seo-d-h/------------/README.md

# Atmega128_Elevator_Project
https://www.youtube.com/watch?v=nzGrvzZ4eBY
## 1. H/W Configuration
### 1) System Operation Part


### 2) System Interface Part


## 2. Flow Chart


## 3. H/W Circuit
### 1) System Operation Part


### 2) System Interface Part
