seo-d-h/------------/보고서_2018144014_서동현.pdf

2018144014 | 서 동 현

# 마이크로프로세서Ⅱ 텀프로젝트 보고서

## 프로젝트 명

< 고오급 엘리베이터 >

목 차

I. 제안 이유 및 필요성-----------------------------

II. 개발 방법 개요

1. 최종 개발 목표 ----------------------------- 3
2. 전체 시스템 구성도 / 센서 및 액추에이터 포함한 H/W구성도
3. 동작 시나리오 제시(Flowchart 및 동작 개요 제시)

III. 요소별 개발 내용 및 검증

1. 각 요소별 회로의 설계 / 구현 결과(회로도 및 동작 검증)
2. 각 요소의 동작을 위한 프로그램 설계 / 구현결과(code 및 동 작검증)
3. 전체 동작 시나리오에 따른 구현

IV. 전체 시나리오에 따른 개발 내용 및 검증

1. 동작 시나리오에 따른 동작 검증
V. 텀프로젝트 수행에 대한 결론 및 기대효과
1. 초기 계획 대비 진행 내용 비교
2. 전체적인 구현에 대한 Overview
3. 프로젝트 진행중 어려웠던 내용과 어떻게 해결하였는지

VI. 소요된 부품 List 및 수행된 일정 정리

## 1장. 제안 이유 및 필요성(산업적/학습 등에 대한 필요성)

1) 산업적 필요성
- 범죄와 테러에 대한 사건 사고 방지

22.08.19 오피스텔 엘리베이터를 기다리던 와중 치한이 묻지마 폭행을 한 사건

이 발생하였다. 이를 예방 및 대비하기 위해 아파트 현관을 인증된 사용자만 출

입 할 수 있도록 한다.

관련자료 : [단독]"엘리베이터 기다리는데 뒤에서 돌려차기" 부산 귀갓길 행인 살인미수 | JTBC 뉴스 (https://news.jtbc.co.kr/article/article.aspx?news_id=NB12071542)
- 4차 산업혁명시대에 맞는 스마트 엘리베이터

오늘날 가정 및 산업에서 이용하는 엘리베이터 시스템은 엘리베이터가 처음 도

입되었을 때 사용한 사용자가 버튼을 눌러야 구동하는 방식임. 4차 산업혁명이

도래됨에 따라 보다 스마트하고 사용자에게 편리하게, 기다리는 시간 없이 엘리

베이터를 사용할 수 있어야 함.

관련자료 : 시간표 데이터를 이용한 엘리베이터 알고리즘 설계[한국정보통신학회 종합 학술대회 눈문집]

22.05 | 122~124
2) 학습 필요성
- 통신 시스템 이해 및 적용

마이크로프로세서2 에서 주로 학습한 통신 시스템(UART, SPI, TWI)을 활용하여

작품을 설계 및 구현한다.

- 센서값에 따른 액추에이터 제어

마이크로프로세서1, 2를 융합하여 센서값을 통해 받아들인 정보에 따라 특정 동

작을 수행하도록 작품을 설계 및 제작한다.

## 2장. 개발 방법 개요

1) 최종 개발 목표
- 승인된 사용자만 건물 출입 할 수 있도록 보안 시스템을 1층 출입문에 구현

한다. 승인여부는 RFID리더기 태그를 통해 승인된 사용자면 출입문이 자동으로

열리게 되며 엘리베이터를 자동으로 1층으로 호출 후, 카드 UID값에 따라 목적

층수를 미리 눌러준다.

승인된 사용자가 아니라면 미승인된 카드라는 경고문구를 LCD 디스플레이에

출력한다.

- 출입문은 서보모터를 이용하여 게이트 open / close를 진행한다.
- 온도센서, 조도세서를 통해 외부환경에 따라 실내 온도 및 조명 환경을 제어

한다.

- 엘리베이터는 리니어 엑추에이터를 이용하여 층 수에 맞게 구별한다.
- 부가적인 기능으로 낮과 밤에 따라서 조도의 값이 바뀌기 때문에

저녁이 되면 조도 값에 따라서 자동으로 복도 LED가 켜진다.

- 예외상황을 대비해 스위치로 엘리베이터를 1층으로 부를 수 있다.

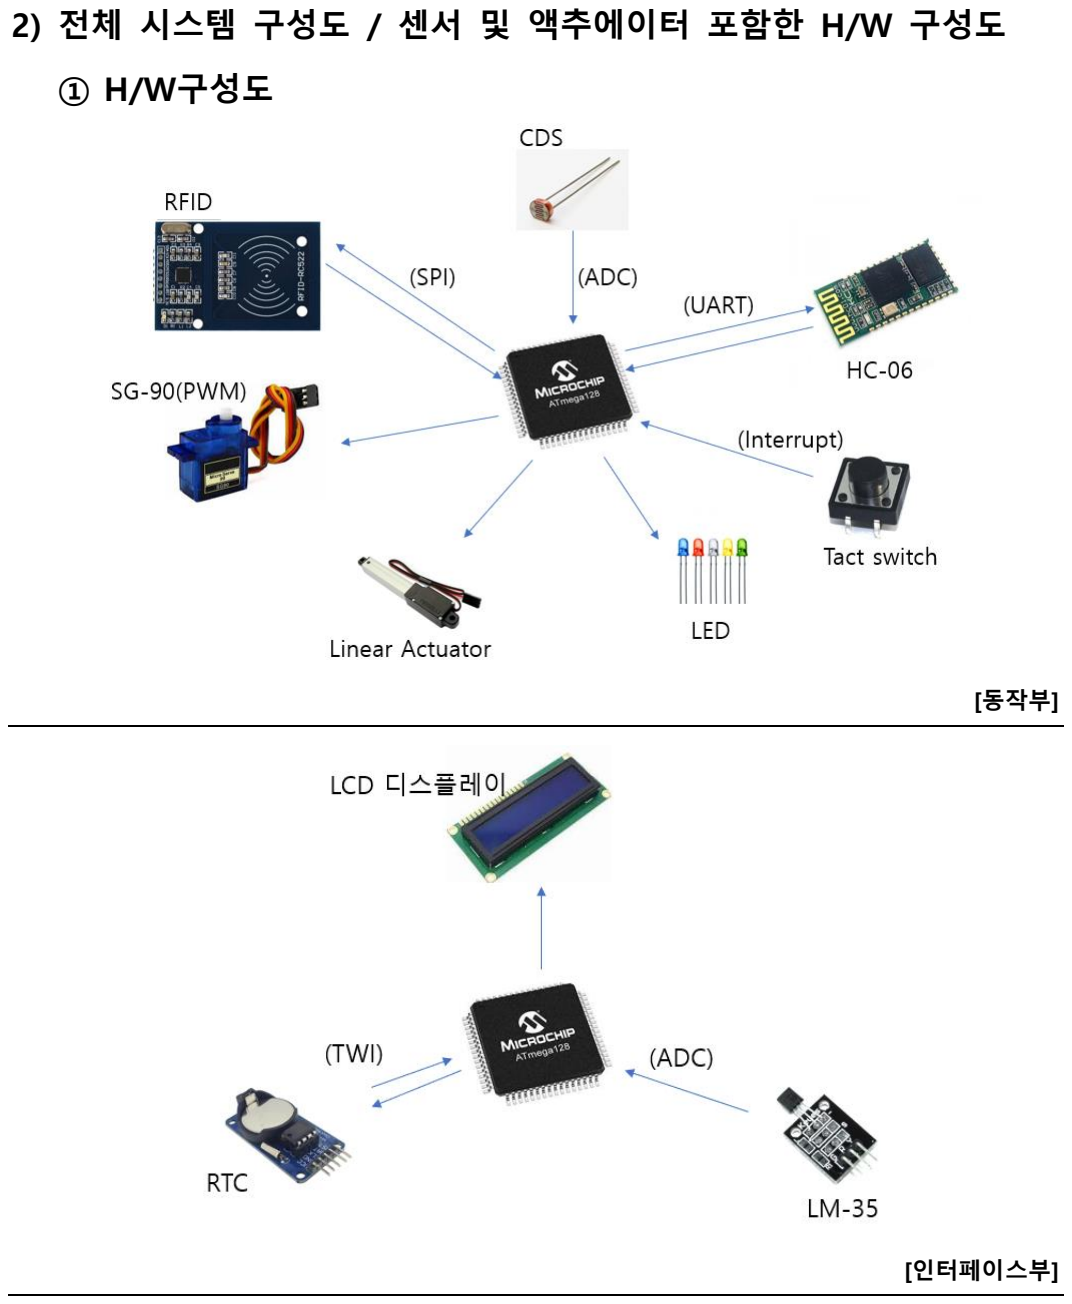
[picture p1: page 5]

2) 전체 시스템 구성도 / 센서 및 액추에이터 포함한 H/W 구성도

① H/W구성도

[동작부]

[인터페이스부]

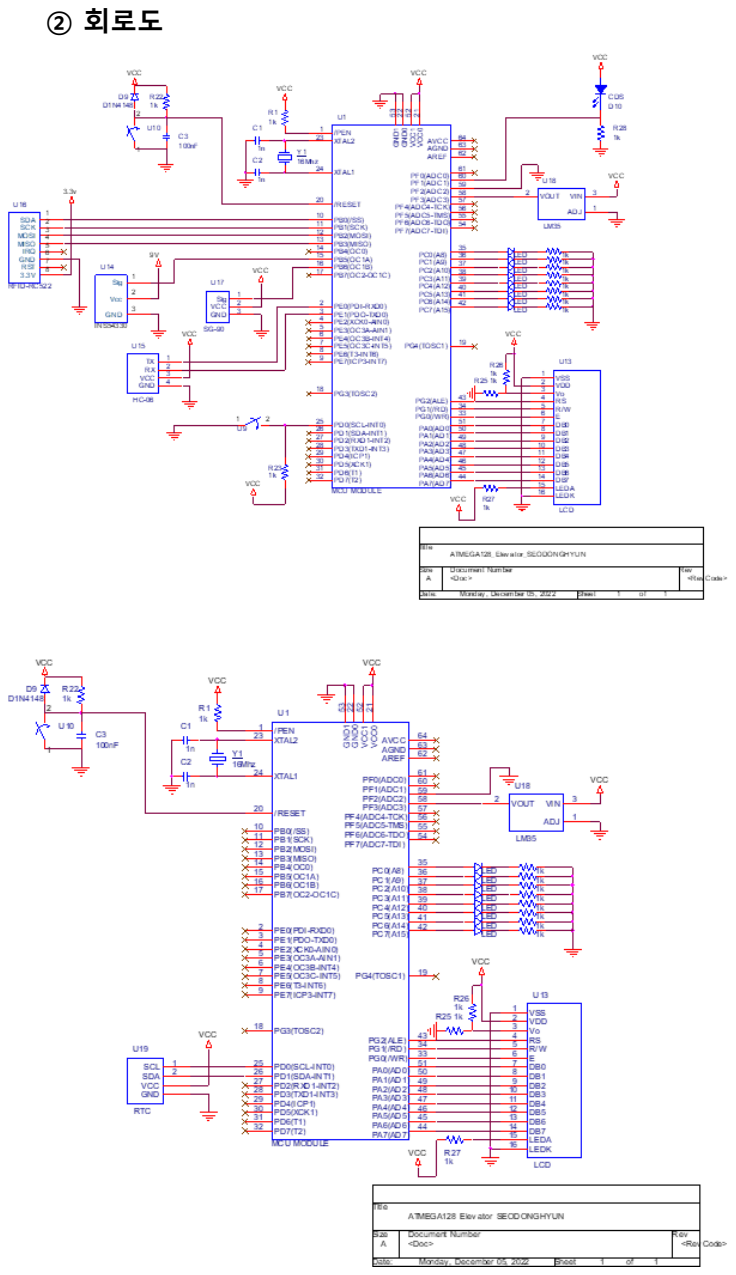
[picture p2: page 6]

② 회로도

3) 동작 시나리오 제시 (Flowchart 및 동작 개요 제시)

① 시스템 구성

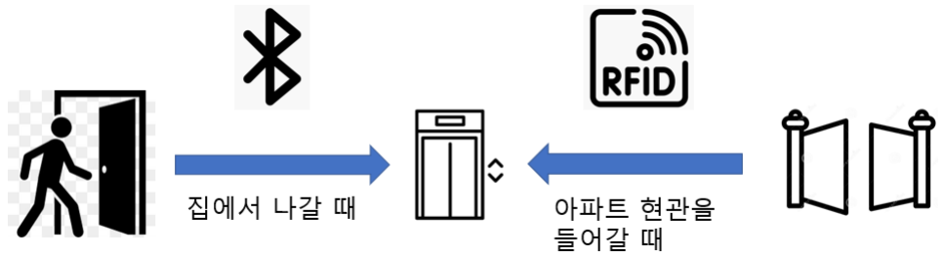
[picture p3: figure]

사용자가 집에서 외출 할 때 휴대폰 블루투스를 통해 엘리베이터를 호출 할

수 있도록 한다. 반대로 실외에서 내부로 출입할 경우는 RFID카드 태그를 통

해 인증된 사용자만 출입을 허용할 수 있도록 게이트를 Open한다.

② 흐름도

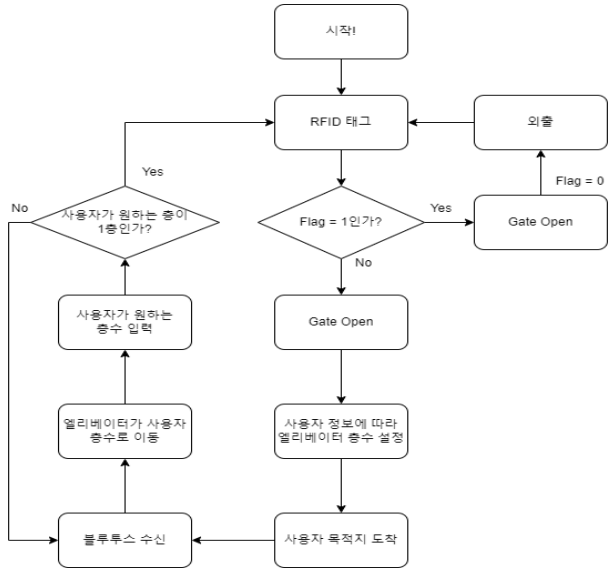
[picture p4: figure]

4) 예외 시나리오 제시 및 대응방안 (Flowchart 및 동작 개요 제시)

① RFID태그시 인증된 사용자가 아닐 경우.

현재 프로젝트에서 uidByte[0]의 값이 0x8C일 경우 2층 거주자, 0x23일 경우

3층 거주자로 등록을 하였다. 등록된 카드 정보에 따라 자동으로 엘리베이터

가 사용자의 거주층수로 이동한다. uidByte[0]의 갑이 0x8C, 0x23이 아닌 다른

값을 수신하면 경고음을 울린다. 이에 따른 예외처리는 다음과 같이 구현하였

다.

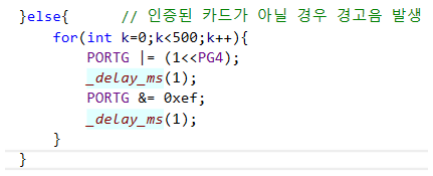
[picture p5: figure]
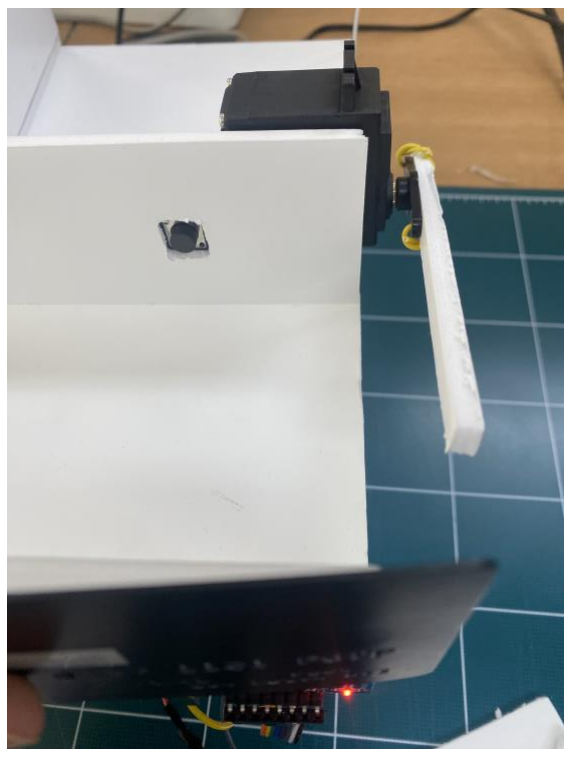
[picture p6: figure]

등록되지 않는 카드가 태그 되면

현관문(서보모터)가 열리지 않고 부저가 울리는 모습

② 엘리베이터를 수동으로 동작 시

예시 상황으로 RFID를 집에 두고 왔을 때를 대비해 1층에 외부인터럽트를

사용한 스위치를 만들어 엘리베이터를 사용 할 수 있도록 한다.

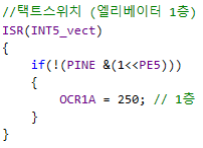
[picture p7: figure]
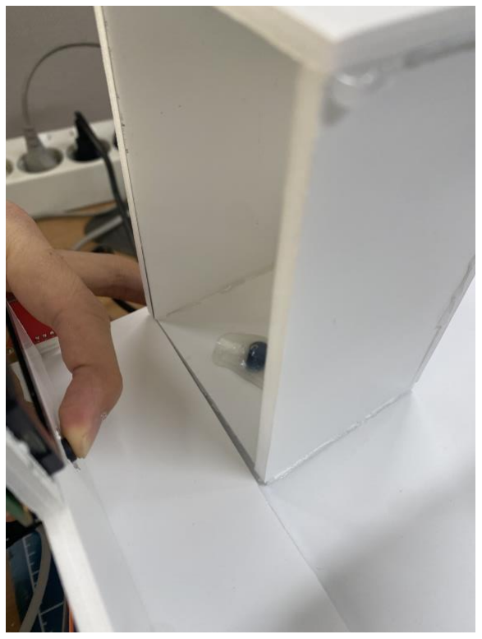
[picture p8: figure]

외부 인터럽트로 연결된 스위치를 누르면

엘리베이터가 1층에 도달하는 모습

## 3장. 요소별 개발 내용 및 검증

1) 각 요소별 회로의 설계 / 구현 결과(회로도 및 동작 검증)

① RFID(SPI)

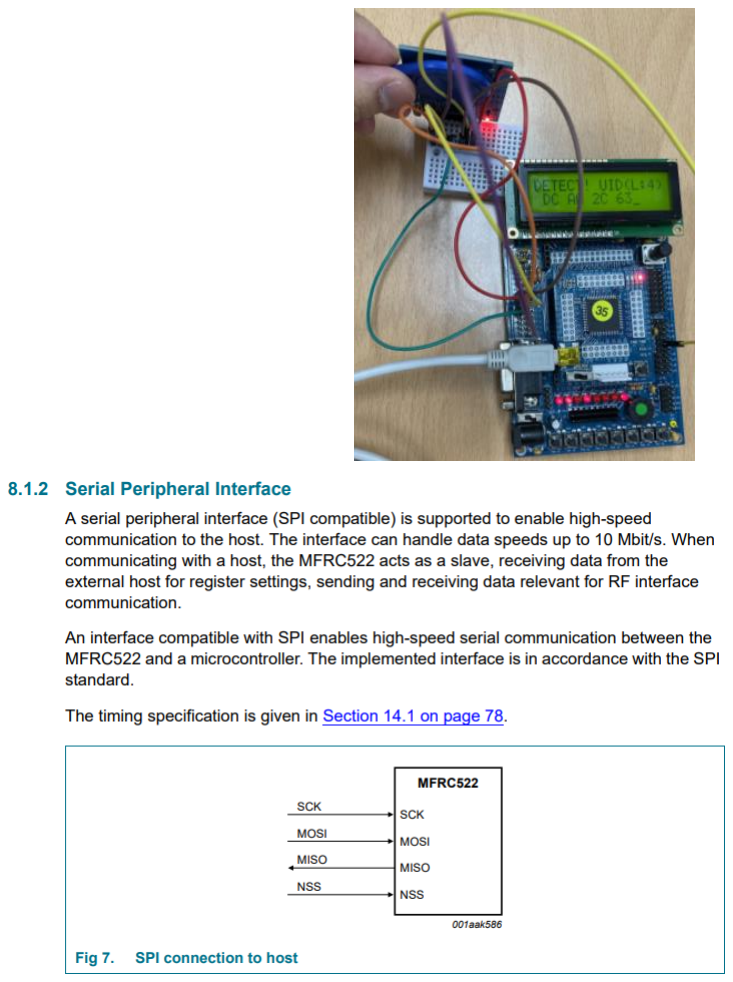
[picture p9: figure]

RC-522 Datasheet

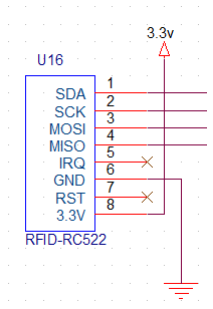
[picture p10: figure]

RFID는 SPI통신으로 하나의 마스터와 다수의 슬레이브가 존재할 수 있으며

“SDA, SCL, MOSI, MISO”총 4개의 선을 이용하여 데이터의 송수신이 가능하다.

SDA는 각 슬레이브에 대한 선택 신호로 마스터에 의해 선택되며 SCL은 마스터

와 슬레이브 간의 동기 클럭 신호로 마스터에서 발생한다. MOSI는 마스터로부

터 슬레이브로 전송되는 데이터 선이며, MISO는 슬레이브로부터 마스터로 전송

되는 데이터 선이다. 송수신되는 데이터를 통해 인증된 사용자인지 아닌지 구별

한다.

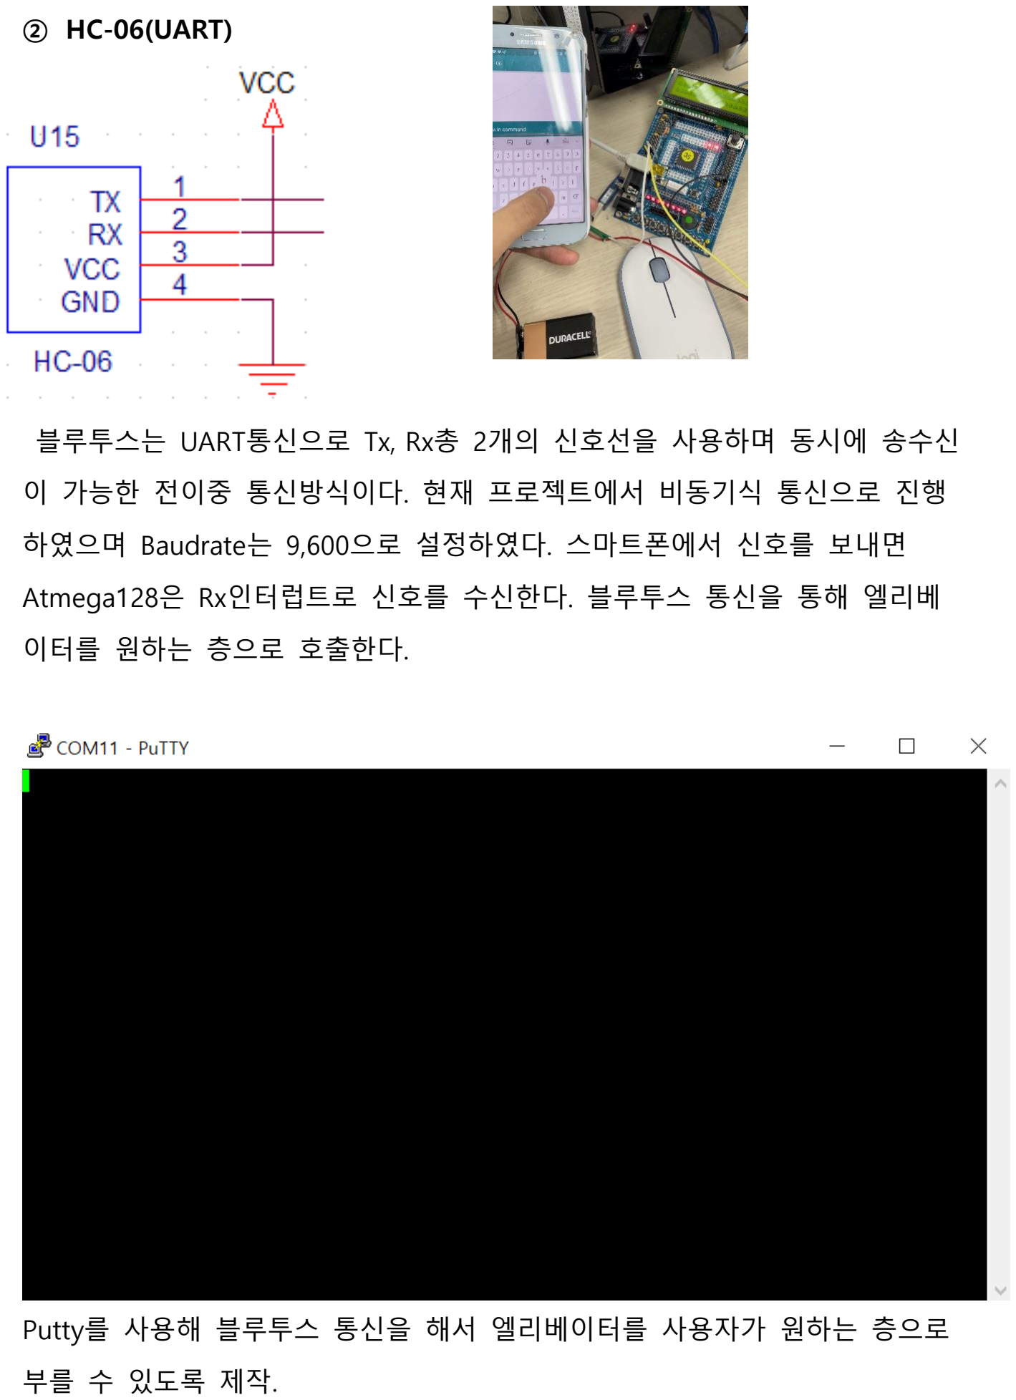
[picture p11: page 11]

② HC-06(UART)

블루투스는 UART통신으로 Tx, Rx총 2개의 신호선을 사용하며 동시에 송수신

이 가능한 전이중 통신방식이다. 현재 프로젝트에서 비동기식 통신으로 진행

하였으며 Baudrate는 9,600으로 설정하였다. 스마트폰에서 신호를 보내면

Atmega128은 Rx인터럽트로 신호를 수신한다. 블루투스 통신을 통해 엘리베

이터를 원하는 층으로 호출한다.

Putty를 사용해 블루투스 통신을 해서 엘리베이터를 사용자가 원하는 층으로

부를 수 있도록 제작.

③ RTC(I2C)

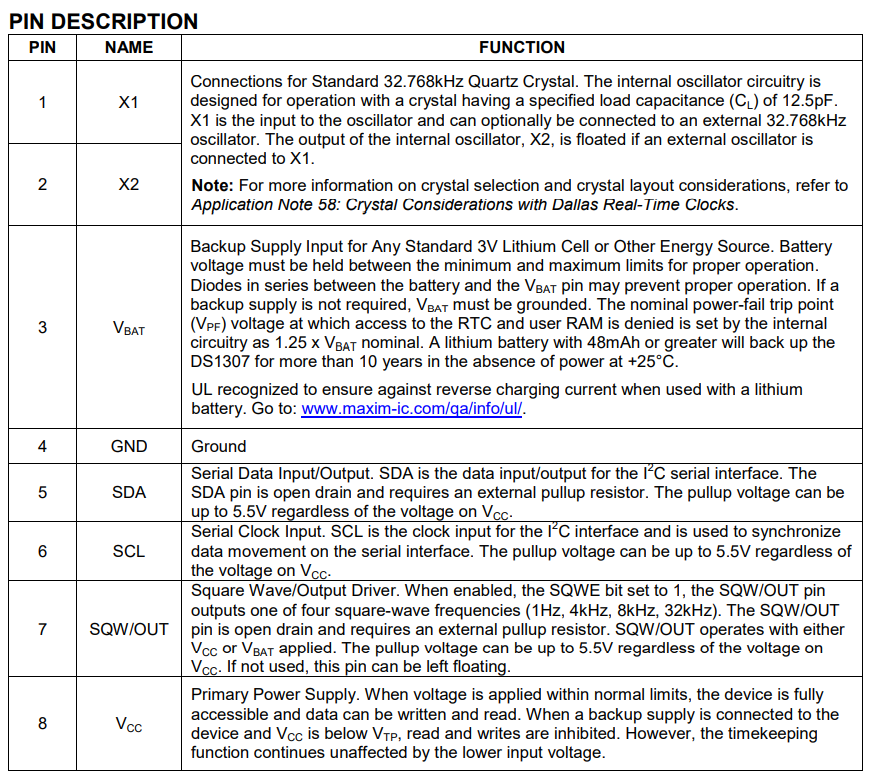
[picture p12: figure]

RTC모듈은 I2C(TWI)통신으로 SCL(직렬클럭), SDA(직렬데이터)의 2개의 양방향

신호선을 이용한 통신방식이다. 1개의 데이터선을 이용하는 반이중 통신방식

이며 SCL동기 클럭을 사용하므로 동기식 통신방식이다.

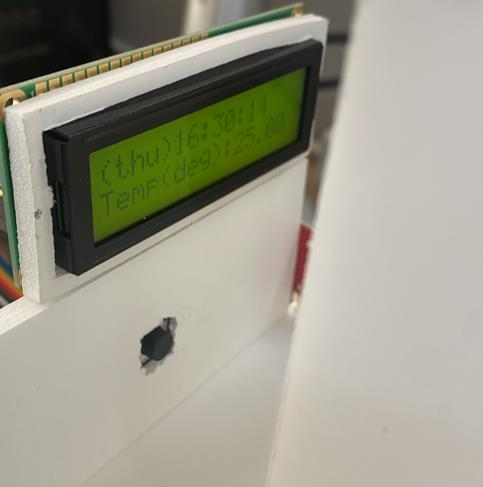
[picture p13: figure]

엘리베이터 맞은 편에

시간을 확인할 수 있도록

RTC값을 변수로 받아 LCD에 표현한 모습

아트메가와 연결한 회로도 모습

④ LM-35 & CdS(ADC)

- LM35

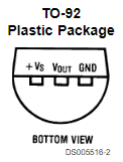
[picture p14: figure]
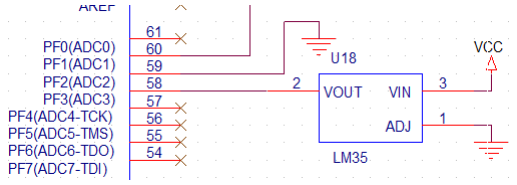
[picture p15: figure]

LM35는 출력전압이 섭씨온도에 선형적으로 비례하는 특징을 가는 정밀 IC온

도센서이다. 동작전압은 datasheet상 4V-30V이기 때문에 시스템 전원 5V를

인가하였다. 현 프로젝트에서 ADC2, ADC3핀을 이용하여 차동입력채널과 10

배 증폭모드를 이용하였다. A/D변환기의 분해능은 10비트이므로 A/D변환 출

력은 1스텝당 4.88mV를 나타낸다. 위 회로도와 같이 진행하면 ADC2를 GND

와 접지하여 ADC3의 신호를 GND기준으로 10배 증폭시킬 수 있다.

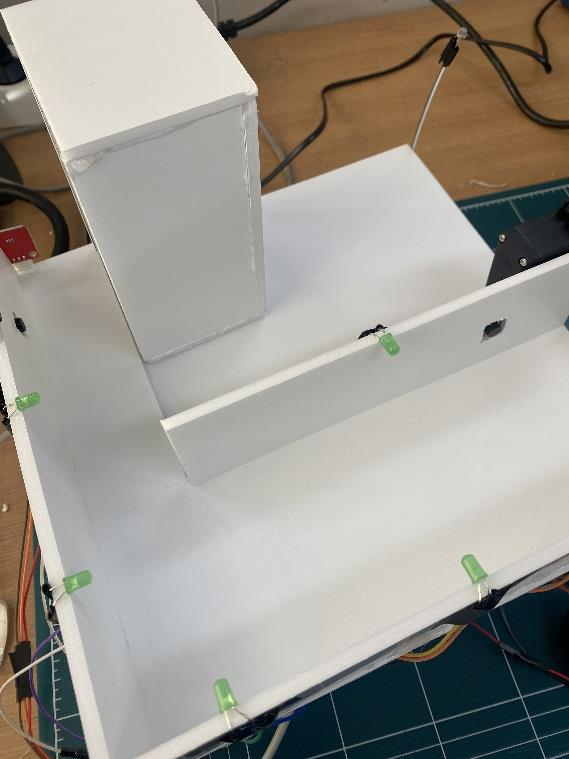
[picture p16: figure]
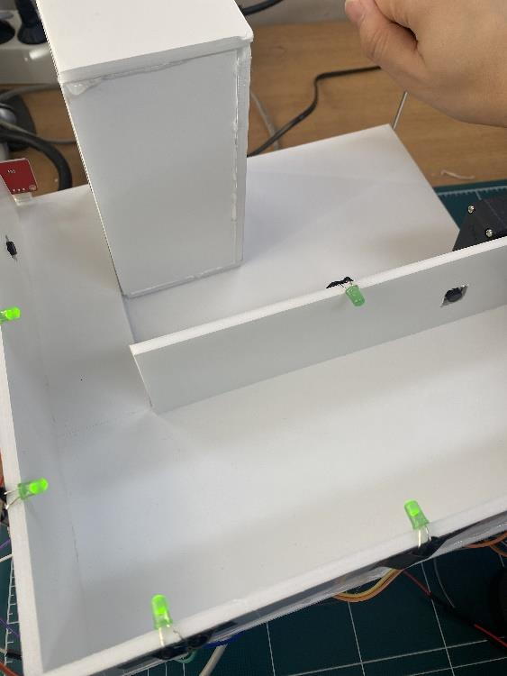
[picture p17: figure]

조도 센서의 값에 따라서 LED가 켜진 모습과 안켜진 모습을 확인할 수 있다.

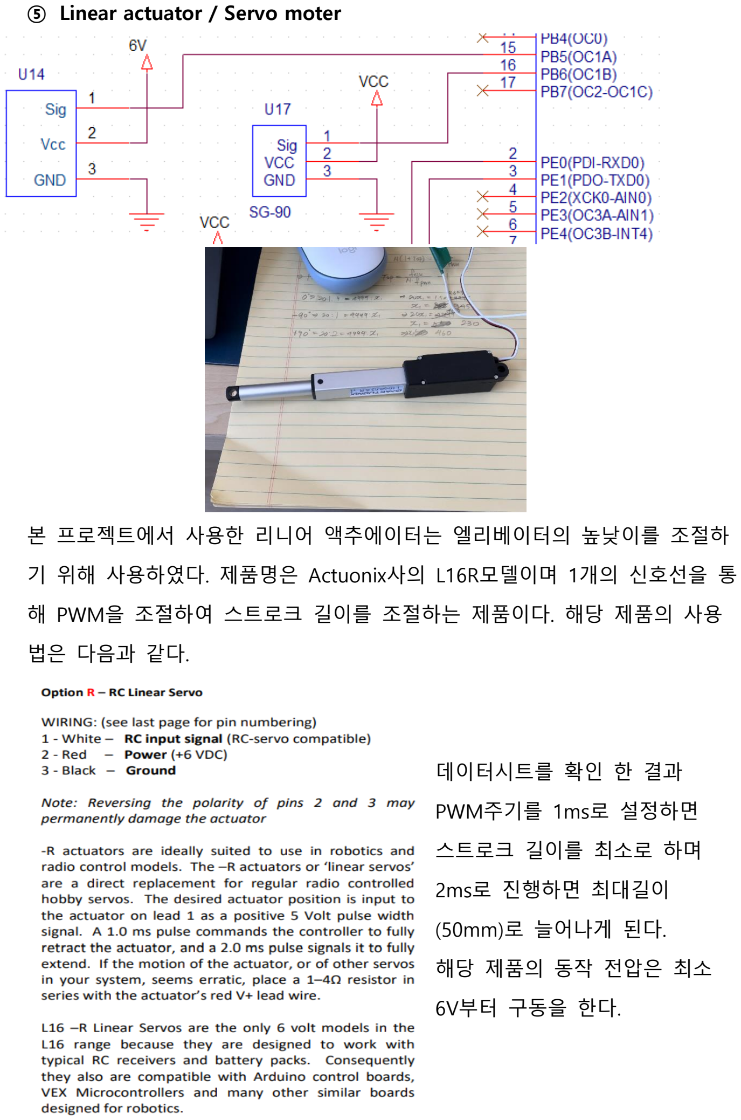
[picture p18: page 14]

⑤ Linear actuator / Servo moter

본 프로젝트에서 사용한 리니어 액추에이터는 엘리베이터의 높낮이를 조절하

기 위해 사용하였다. 제품명은 Actuonix사의 L16R모델이며 1개의 신호선을 통

해 PWM을 조절하여 스트로크 길이를 조절하는 제품이다. 해당 제품의 사용

법은 다음과 같다.

데이터시트를 확인 한 결과

PWM주기를 1ms로 설정하면

스트로크 길이를 최소로 하며

2ms로 진행하면 최대길이

(50mm)로 늘어나게 된다.

해당 제품의 동작 전압은 최소

6V부터 구동을 한다.

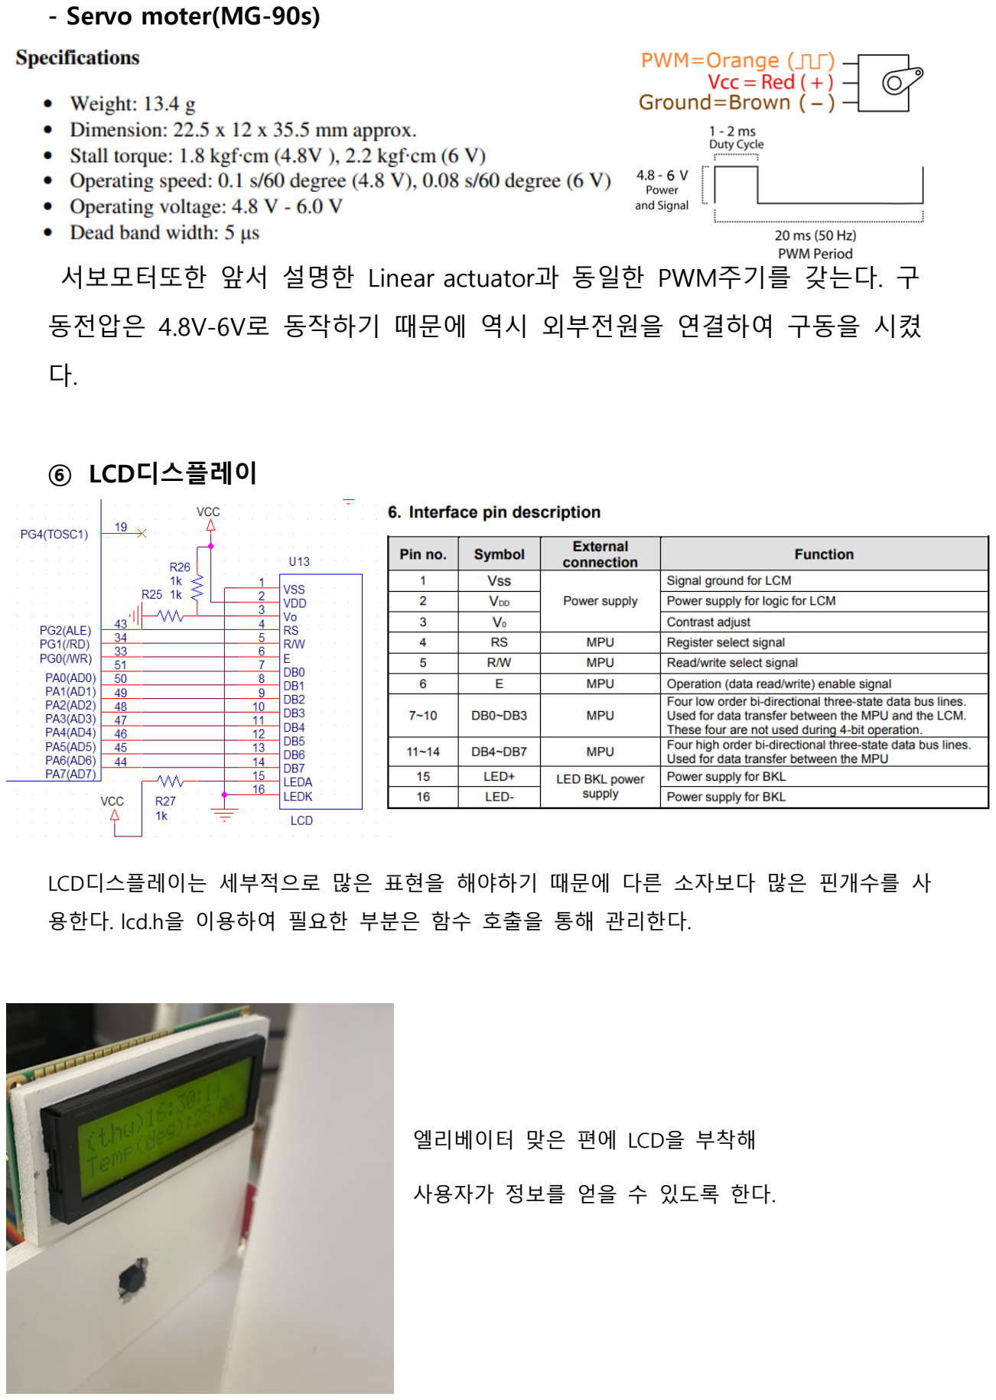
[picture p19: page 15]

- Servo moter(MG-90s)

서보모터또한 앞서 설명한 Linear actuator과 동일한 PWM주기를 갖는다. 구

동전압은 4.8V-6V로 동작하기 때문에 역시 외부전원을 연결하여 구동을 시켰

다.

⑥ LCD디스플레이

LCD디스플레이는 세부적으로 많은 표현을 해야하기 때문에 다른 소자보다 많은 핀개수를 사 용한다. lcd.h을 이용하여 필요한 부분은 함수 호출을 통해 관리한다.

엘리베이터 맞은 편에 LCD을 부착해

사용자가 정보를 얻을 수 있도록 한다.

⑦ Tact Switch

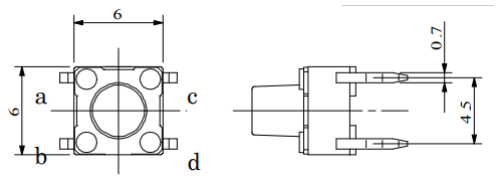
[picture p20: figure]

택트스위치는 외부 인터럽트를 이용하여 프로그램의 규약을 받지 않고 언제

어디서든 스위치를 누르게 되면 특정동작을 즉시 수행하는 목적으로 사용한

다.

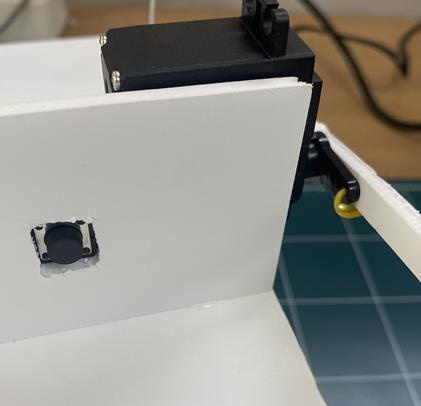
[picture p21: figure]

외부인터럽트 4번과 연결한

서보모터 동작 스위치

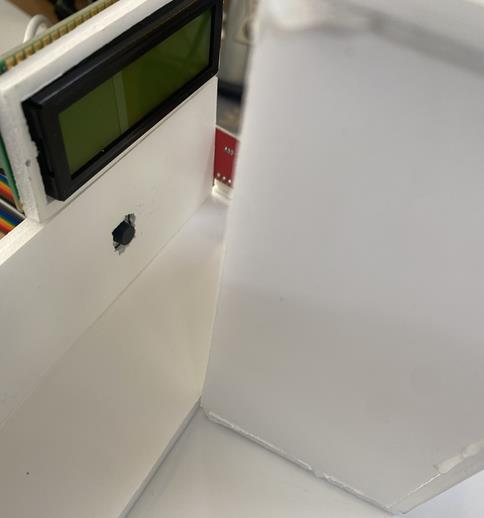
[picture p22: figure]

외부인터럽트 5번과 연결한

엘리베이터 동작 스위치

2) 각 요소의 동작을 위한 프로그램 설계 / 구현 결과(Code 및 동작

검증)

<블루투스>

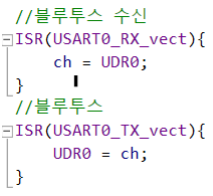
[picture p23: figure]

블루투스 동작을 위한

인터럽트 서비스 루신

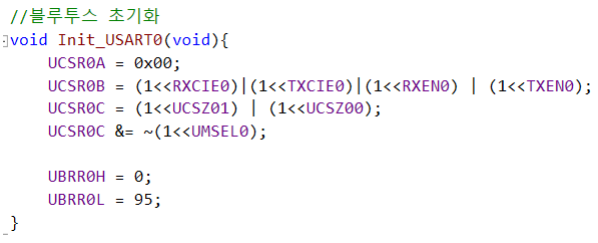
[picture p24: figure]

블루투스 동작을 위한 초기화 함수

main문 안에 있는 블루투스

통신 동작 코드

블루투스 수신 값 UDR0를

변수 ch에 저장해서 ch를

통해서 엘리베이터를

사용자가 원하는 층 수로

올 수 있도록 변수를 저장.

OCR1A값에 따라서

리니어 엑츄에이터의

출력 파형(duty cycle)이

결정된다.

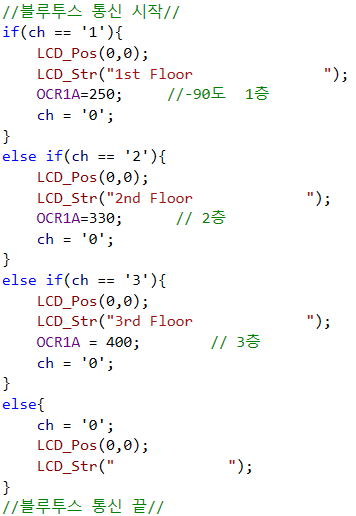
[picture p25: figure]

# 전체적인 코드는 파일 첨부 하도록 하겠습니다 #

<RFID>

RFID의 동작 코드

UID 값으로 사용자를 인식해

사용자의 정보가 저장된

층으로 엘리베이터를 보낸다

또한 OCR1B의 값이 변경되어

서보모터를 통해 현관문이

열리고 3초 뒤에 서보모터가

다시 닫히는 구조이다.

인증된 사용자가 아닐 경우

부저가 울리면서 경고음이

발생하도록 저장되어있다.

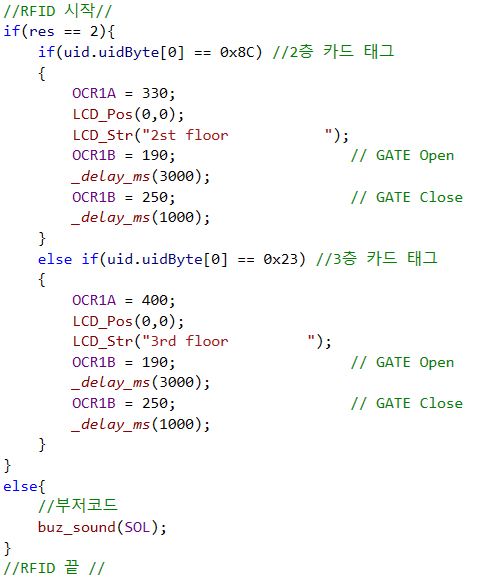
[picture p26: figure]

# 전체적인 코드는 파일 첨부 하도록 하겠습니다 #

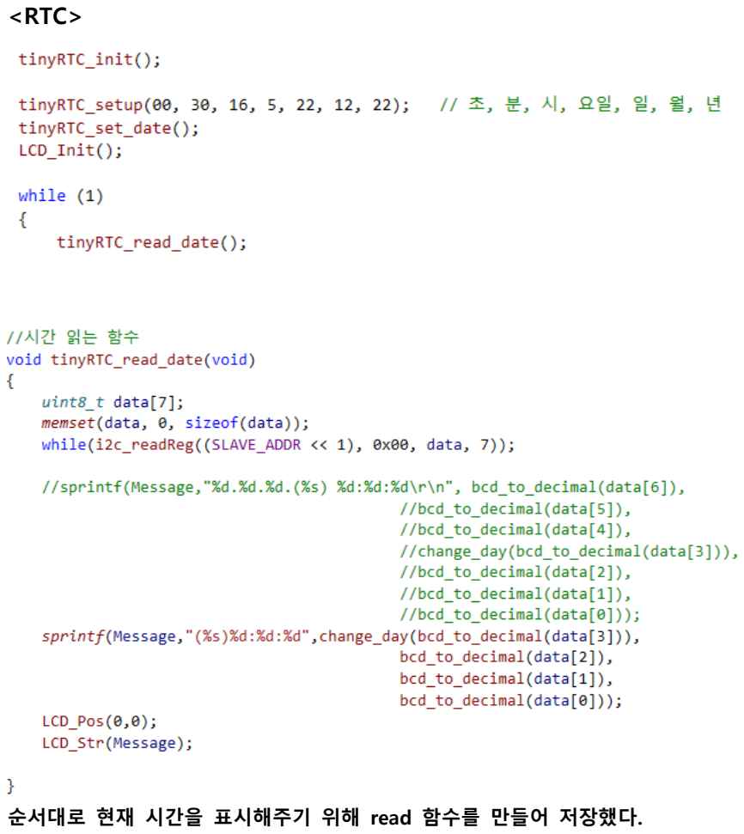
[picture p27: page 20]

<RTC>

순서대로 현재 시간을 표시해주기 위해 read 함수를 만들어 저장했다.

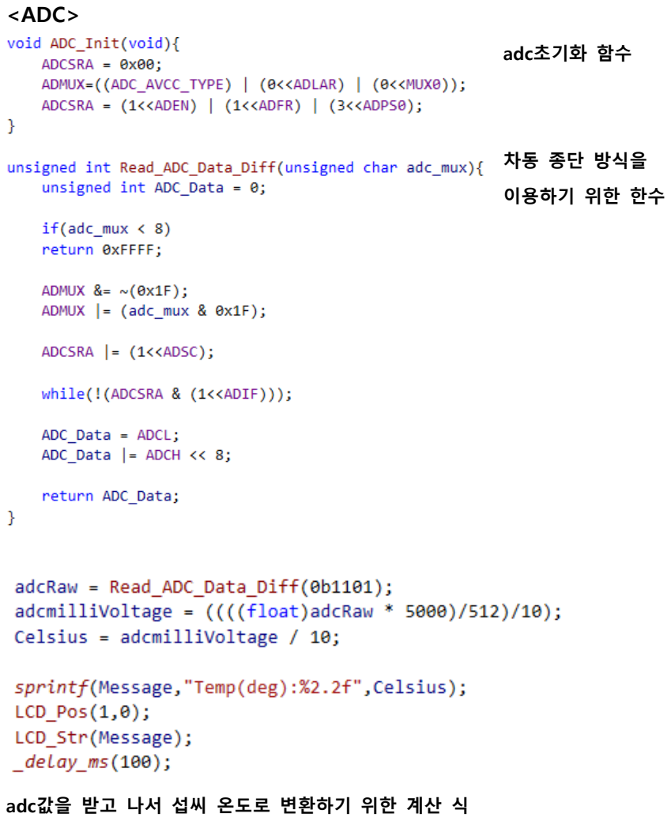
[picture p28: page 21]

<ADC>

adc초기화 함수

차동 종단 방식을

이용하기 위한 한수

adc값을 받고 나서 섭씨 온도로 변환하기 위한 계산 식

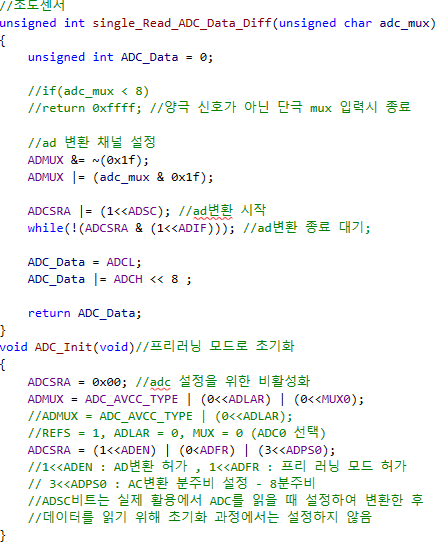
[picture p29: figure]

단일 입력 방식으로 사용하기 위한 함수 및 초기화 함수

<인터럽트>

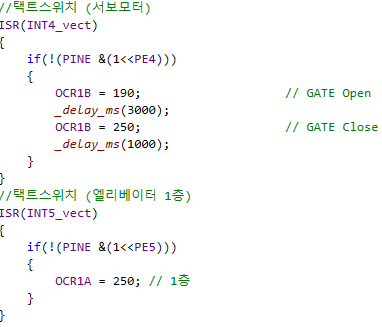
[picture p30: figure]

인터럽트 서비스 루틴으로

외부인터럽트 4번을 사용해

서보모터를 제어한다.

인터럽트 서비스 루틴으로

외부인터럽트 5번을 사용해

리니어 엑츄에이터를 제어

한다

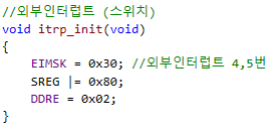
[picture p31: figure]

EIMSK에서 외부인터럽트 4,5번을

활성화 시키기 위한 비트 설정

## 4장. 전체 시나리오에 따른 개발 내용 및 검증

#전체 동작 영상은 맨 마지막 페이지에 링크로 첨부하였습니다#

1) LCD디스플레이에 현재시간 및 온도 표시

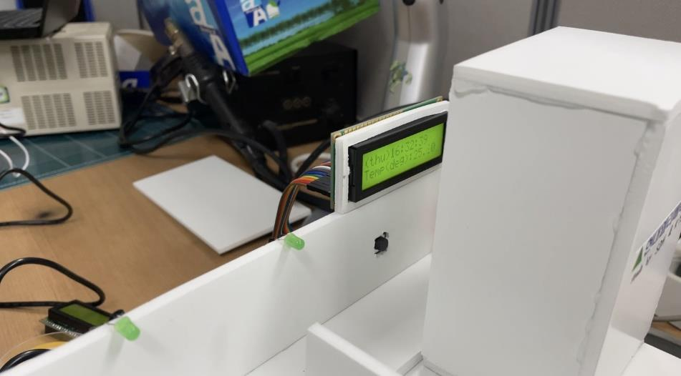
[picture p32: figure]

RTC모듈을 통해 시스템 시간이 계속해서 흐르며 온도센서(LM35)를 통해 수신된

현재 온도를 LCD디스플레이에 출력한다. 시간은 1초에 한번씩 update가 이루어

지며 “(요일)시:분:초”의 표기법으로 디스플레이에 출력한다. 온도는 센서의 값이

변회될 때 마다 update가 이루어 진다.

2) 외부조도에 따른 실내조명 제어

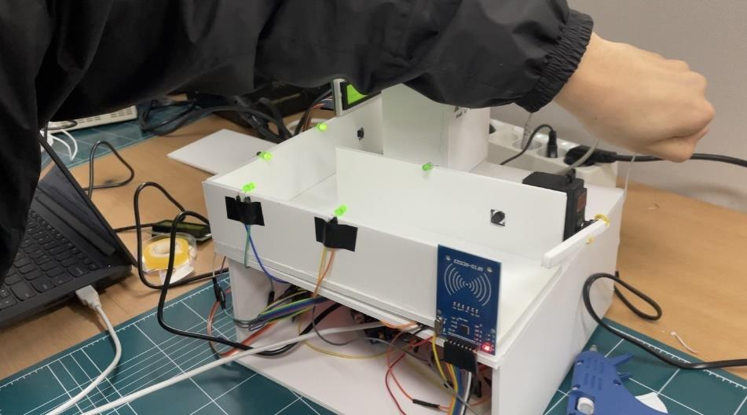
[picture p33: figure]

조도센서를 통해서 외부 조도가 낮을 경우(밤) 실내 조명(LED)을 자동으로 키고

외부 조도가 높으면 실내조명을 켠다. LED는 복도에 총 5개를 배치하였다.

3) 카드 태그에 따라 게이트open, 엘리베이터 높이조절

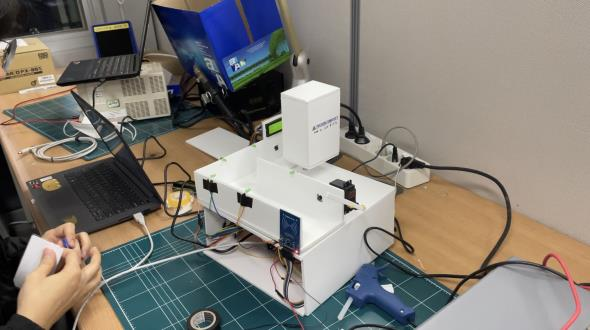
[picture p34: figure]
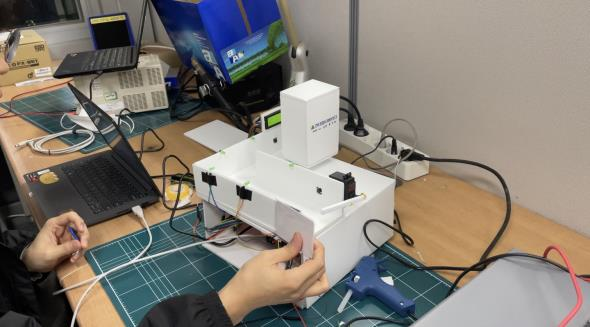
[picture p35: figure]

RFID리더기에 인증된 카드가 태그되면 서보모터를 통해 게이트가 open되며 엘

리베이터가 자동으로 사용자의 거주 층으로 높이를 조절한다. 카드의 UID의 첫번

째 인덱스 값이 0x8C일 경우 엘리베이터가 2층으로 이동하며 첫번째 인덱스 값

이 0x23이면 3층으로 이동한다. 인증되지 않은 사용자의 카드를 태그한다면 부저

를 통해 경고음을 발생한다.

4) 블루투스 통신으로 엘리베이터 호출

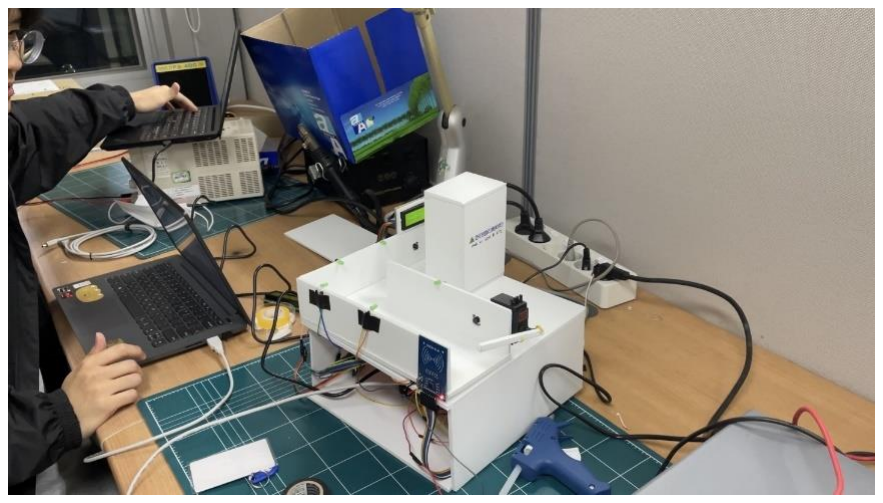
[picture p36: figure]

HC-06블루투스 모듈을 이용하여 UART 시리얼 통신을 통해 데이터를 수신받는

다. 사용자가 단말기(휴대폰, 노트북 등)에서 데이터를 전송하면 엘리베이터를 사

용자의 거주 층 수로 호출 할 수 있다.

5) 외출시 스위치로 게이트 open

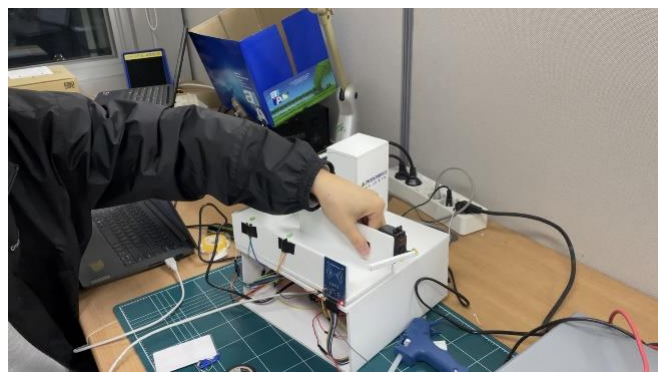
[picture p37: figure]
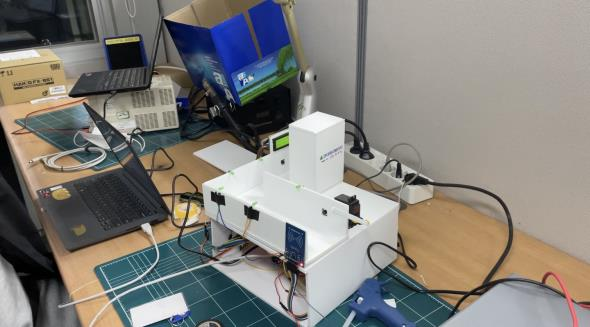
[picture p38: figure]

사용자가 실내에서 실외로 외출을 할 경우 게이트 옆에 있는 스위치 버튼을 눌

러서 게이트를 open할 수 있다. 스위치는 언제든 누를 수 있기 때문에 외부 인터

럽트를 통해 시스템을 구현하였다.

## 5장. 텀프로젝트 수행에 대한 결론 및 기대효과

- 초기 계획 대비 진행 내용 비교

처음 프로젝트를 계획했을 때 구상했던 내용의 가장 핵심은 RFID 카드 태그에

따른 모터 동작이 중요했고, 또 다른 포인트는 Bluetooth 동작을 만들어서

엘리베이터 사용에 있어 집으로 들어오는 사용자와 집에서 나가는 사용자를

구분하는 부분이었다. 집으로 들어갈 때에는 등록된 RFID 카드로만 현관문이

열리는 시스템이고 등록된 카드는 본인의 UID에 따라서 엘리베이터가 지정된

층으로 이동되는 동작까지 계획이었고 계획과 다른 차이점 없이 동작이 잘

구현되었음을 알 수 있다. 보안이라는 문제에 있어서 대중적으로 사용되는

엘리베이터를 현관문까지 연장시켜 RFID 태그 사용, 내부 switch를 사용해

보안성과 안정성을 높이는 기대효과를 얻을 수 있다.

부가적인 계획 중 서보모터를 현관문으로 사용하기로 했었는데 서보모터는

마이크로프로세서1 수업 때 사용했던 경험이 있어서 금방 동작 제어를

완료할 수 있었다. 계획에 없던 내용으로 내부에서 스위치를 사용해

서보 모터를 동작 제어하는 부분이 있었는데, 이 부분에서는 외부 인터럽트를

사용해야했다. 아트메가 자체에 내장된 스위치는 PORTD에 있지만 아트메가

자체를 하드웨어에 붙이기에는 하드웨어 프레임이 완성도가 떨어진다고

생각해서 아트메가의 데이터시트를 보면서 외부 인터럽트 4,5,6,7 번이

PORTE의 4,5,6,7번에 있는 것을 찾았고 PORTE의 상위 비트에서 출력신호를

끌어서 스위치에 연결하면 외부 인터럽트를 충분히 사용 할 수 있다고

생각했다. 이 계획은 순조롭게 잘 진행됐고 스위치는 슬라이드 스위치 보다는

택트 스위치가 동작 구현에 더 잘 어울린다고 생각이 들어서 택트 스위치로

PCB 기판에 납땜하고 연결해서 외부 인터럽트를 이용한 스위치는 해결되었다.

첫 계획때에는 하드웨어 프레임을 그렇게 세부적으로 생각하지 않았는데

직접 센서들을 제어하고 리니어 엑츄에이터를 동작시켜보니 생각보다 하드웨어

프레임 제작이 까다롭다는 것을 새롭게 알게 되었다.

각종 센서들을 이은 점퍼선과 전원선, RFID, Bluetooth 등등 한번에 여러가지를

사용하다보니 생각한 하드웨어 프레임 크기가 조금 협소하게 느껴졌다.

초기 계획에는 아트메가를 1개만 사용할 예정이었는데 여러가지 센서들을 사용

하다보니 포트가 부족해서 아트메가를 2개 사용할 것으로 수정하였다.

포트 수가 여유로워져서 각종 센서들을 더 추가할 수 있었고 동작에 부가적인

기능을 넣을 수 있어서 하드웨어 프레임을 제작하고 직접 동작을 확인 할 때

완성도가 높다는 것을 확실히 느낄 수 있었다.

- 전체적인 구현에 대한 Overview

여러가지 구현을 하다보니 예상하지 못한 변수들도 많이 있었다고 생각한다.

서보모터와 리니어 엑츄에이터는 전류를 많이 잡아먹는 센서들이어서

아트메가에 직접 넣어주는 전원 이외에도 서보모터에는 배터리를 이용해서

외부 전원을 넣어주었고 리니어 엑츄에이터에는 파워 서플라이를 이용해서

외부 전원을 넣어주었다. 처음 외부전원을 리니어 엑츄에이터에만 넣어주었을

때에는 LCD 화면 점등 현상이 심하고 서보 모터 떨림 현상이 심했다.

이 문제를 해결하기 위해서 배터리를 추가했고 정말 없던 일처럼 점등 현상이

없어지고 서보 모터 떨림 현상도 해결됐다.

여러가지 센서와 모듈들을 사용하면서 데이터시트에 아주 조금 익숙해졌다고

생각하는데 RTC모듈, 온도 센서 모듈, 조도 센서 등 간단하지만 회로도 연결을

해주면서 공통 접지의 중요성도 알게되었다. 공통 접지를 하고서도 아트메가의

접지를 연결 안하는 경우도 있었고 예상하지 못한 변수 상황들이 많았다고

생각한다. 하드웨어 프레임을 제작할 때에는 여러가지 많이 깨닫게 되었는데

그 중 가장 크게 깨닫게 된 것은 하드웨어 구현할 때에도 크기, 수치 등

세부적인 내용까지도 계획하는 것이 중요하다는 것이 중요했다.

처음 계획할 때에는 큰 그림만 잡고 폼보드를 사용해 붙일 예정이었는데

크기를 어림잡아 하다보니 마지막에 점프선, 전원선, 센서, 모듈 등 여러가지를

한 번에 정리할 때가 되니 생각보다 하드웨어 프레임의 크기가 협소하다고

생각이 많이 들었다.

- 프로젝트 진행중 어려웠던 내용과 어떻게 해결하였는지.

가장 어려웠던 부분은 RFID 태그가 어려웠다. 예제 소스도 많이 없었고

아두이노를 사용할 때에는 헤더파일이 있기 때문에 쉽게 사용 할 수 있지만

AVR로 사용할 때에는 헤더파일을 직접 레지스터 비트 제어를 하는 방법으로

RFID 태그를 진행했다. 아두이노 헤더파일을 분석하고 rc522의 datasheet를

보면서 직접 레지스터를 찾았고 필요한 함수들만 조금씩 가져와 사용해서

문제를 해결 할 수 있었다. 이 과정이 글로 보면 조금 짧지만 대략 2주간

여러 자료를 보면서 긴 시간을 쏟았고 결국 해결 할 수 있어서 굉장한

뿌듯함을 느꼈다. 그렇게 시간이 조금 지난 뒤 RFID 관련으로 교수님께서

보충자료를 올려주셨고 확실히 내가 짠 코드보다 완성도가 높다는 것을

확실히 체감 할 수 있었고 아직 갈 길이 멀다는 걸 느꼈다.

- 진행 미비점 분석 및 발전방향

상용화가 되고 대중화가 되려면 앱인벤터를 사용해 블루투스 모듈을 사용하면

좋을 것 같다는 생각이 든다. 팀원 모두가 아이폰이라 계획 방향이었던 핸드폰

으로는 직접 연결해서 블루투스 통신을 완료하지 못한 점이 조금 아쉽긴하지만

대체방안으로 노트북 블루투스 통신을 이용해 동작을 완료시킬 수 있었다.

앱인벤터로 직접 블루투스 앱을 만들어서 엘리베이터 동작과 연동시켜

확인 하는 것이 앞으로의 발전 방향이라고 생각한다.

또한, 엘리베이터와 현관문을 연결시켜 프로젝트에서 소형화해 구현한 것처럼

더 나아가서는 주차장, 아파트 단지 전체로 범위를 폭넓게 넓혀서 연동한다면

4차 산업혁명 스마트 시대에 맞는 좋은 발전 방향을 가진다고 생각한다.

- 본 과제물의 기대 효과

본 프로젝트는 앞서 말했듯이 사건, 사고 방지와 4차 산업혁명 시대에 맞는

스마트 엘리베이터 라는 점에 초점을 맞추고 있다.

인증된 사용자만 아파트 현관을 출입할 수 있고 엘리베이터를 사용할 수

있기 때문에 외부인에 의한 사건, 사고 등을 방지하는 기대효과를 누릴 수

있다. 또한, 4차 산업 혁명 시대에 맞게 모든 동작을 수동적으로 해야하는

아파트 들이 대다수이지만 이 과제물의 취지가 대중적으로 상용화 된다면

수동적이고 직접적으로 동작하는 일들이 줄어들면서 삶 속에서 편리함을

체감할 수 있는 계기가 될 것이다. 엘리베이터, 현관문에 국한된 것이 아니라

아파트 전체, 주차장, 차단기 등등 광범위하게 범위를 넓혀간다면 4차 산업

혁명 시대에 맞게 스마트 엘리베이터, 스마트 아파트 등 여러 산업물로

발전할 가능성이 크다고 생각한다.

## 6장. 소요된 부품 List 및 수행된 일정 정리

<소요 부품 List>

구성품 | 수량 | 기능
LED | 5 | 조도 값에 따른 조명 역할
Tact switch | 2 | 외부 인터럽트 수신 및 동작
CdS(조도 센서) | 1 | 조도 값 수신
LM35(온도 센서) | 1 | 현재 온도 값 수신
LCD | 1 | 온도 및 날짜 표현
SG-90(서보모터) | 1 | 출입문 역할
tinyRTC | 1 | 현재 시간 측정 모듈
RC522-RFID | 1 | RFID 태그 모듈
Linear actuator | 1 | 엘리베이터 동작 모터
HC-06(Bluetooth) | 1 | 블루투스 통신 모듈

<수행 일정 정리>

11/14 ~ 11/20 | 계획 수정 및 동작 검증
11/21 ~ 11/27 | RFID, Bluetooth 동작 검증
11/28 ~ 12/04 | RFID, 각종 센서 동작 검증
12/05 ~ 12/11 | 센서 동작 검증 및 H/W 프레임 제작
12/12 ~ 12/21 | H/W 프레임 제작 및 보고서 작성

#전체 동작 영상 링크입니다#

https://www.youtube.com/watch?v=nzGrvzZ4eBY
